Kerb4k/FI-EtherCAT/(list of files, drawings)

Other design files:
Universal slave/DB10012_ControlController.SchDoc
Universal slave/DB10012_ControlEtherCAT.SchDoc
Universal slave/DB10012_ControlIOConnector.SchDoc
Universal slave/DB10012_ControlPower.SchDoc
Universal slave/DB10012_ControlTopLevel.SchDoc
Universal slave/DB10012_ControlUSBSerial.SchDoc
Universal slave/DB10012_GyroNunchuck.PcbDoc
Universal slave/DB10012_GyroNunchuck.PrjPcb
Universal slave/DB10012_GyroTopLevel.SchDoc
Universal slave/DB10012_IMU.PcbDoc
Universal slave/DB10012_IMU.PrjPcb
Universal slave/DB10012_IMUTopLevel.SchDoc
Universal slave/DB10012_UniversalSlave.PrjPcb
