Kerb4k/FI-EtherCAT/KiCAD/FIU/FIU.kicad_pcb

## KiCad design KiCAD/FIU/FIU.kicad_pcb (2023-11-26)

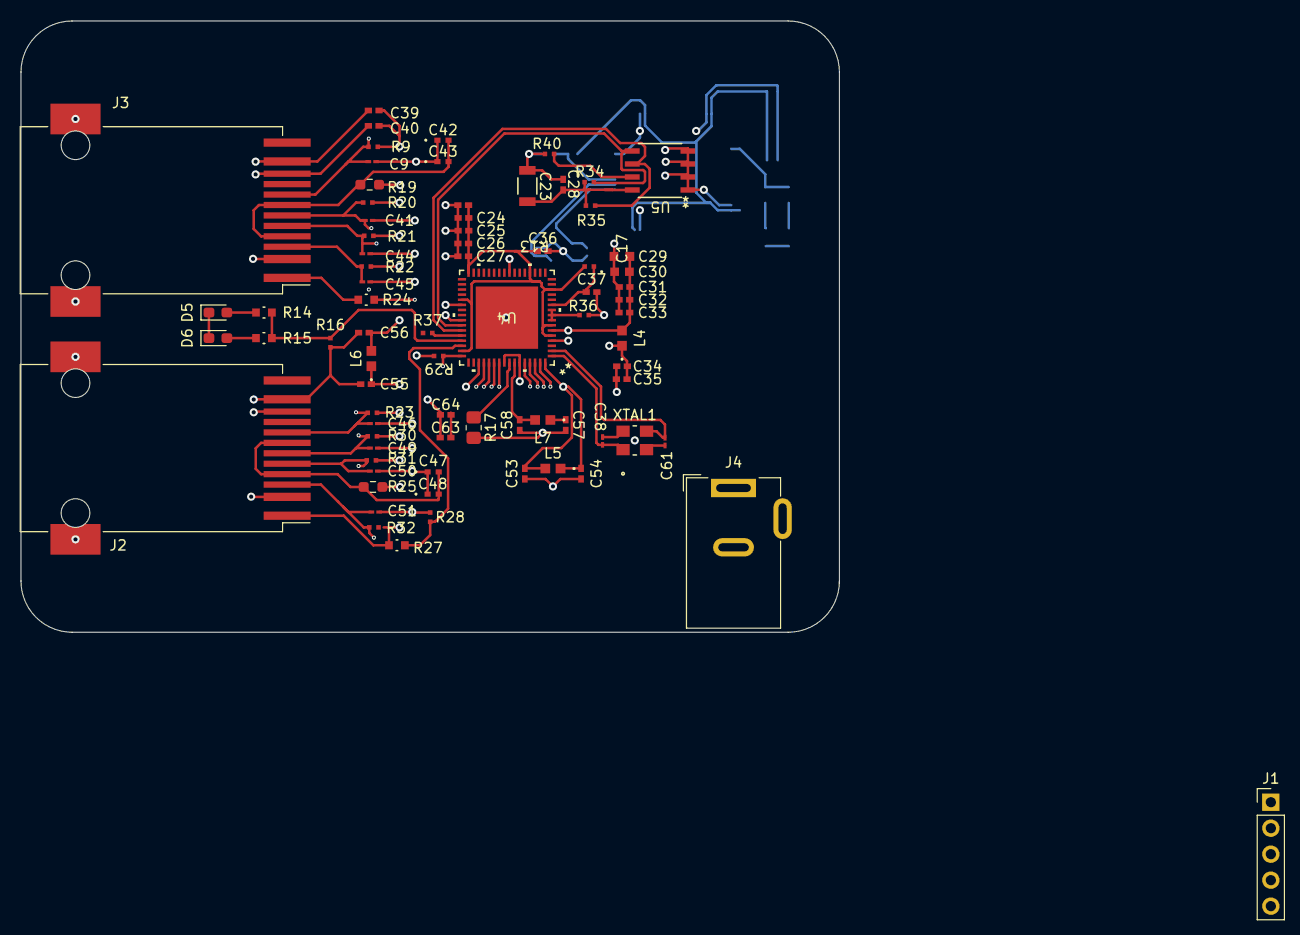
[picture p1: board FIU.kicad_pcb from above]

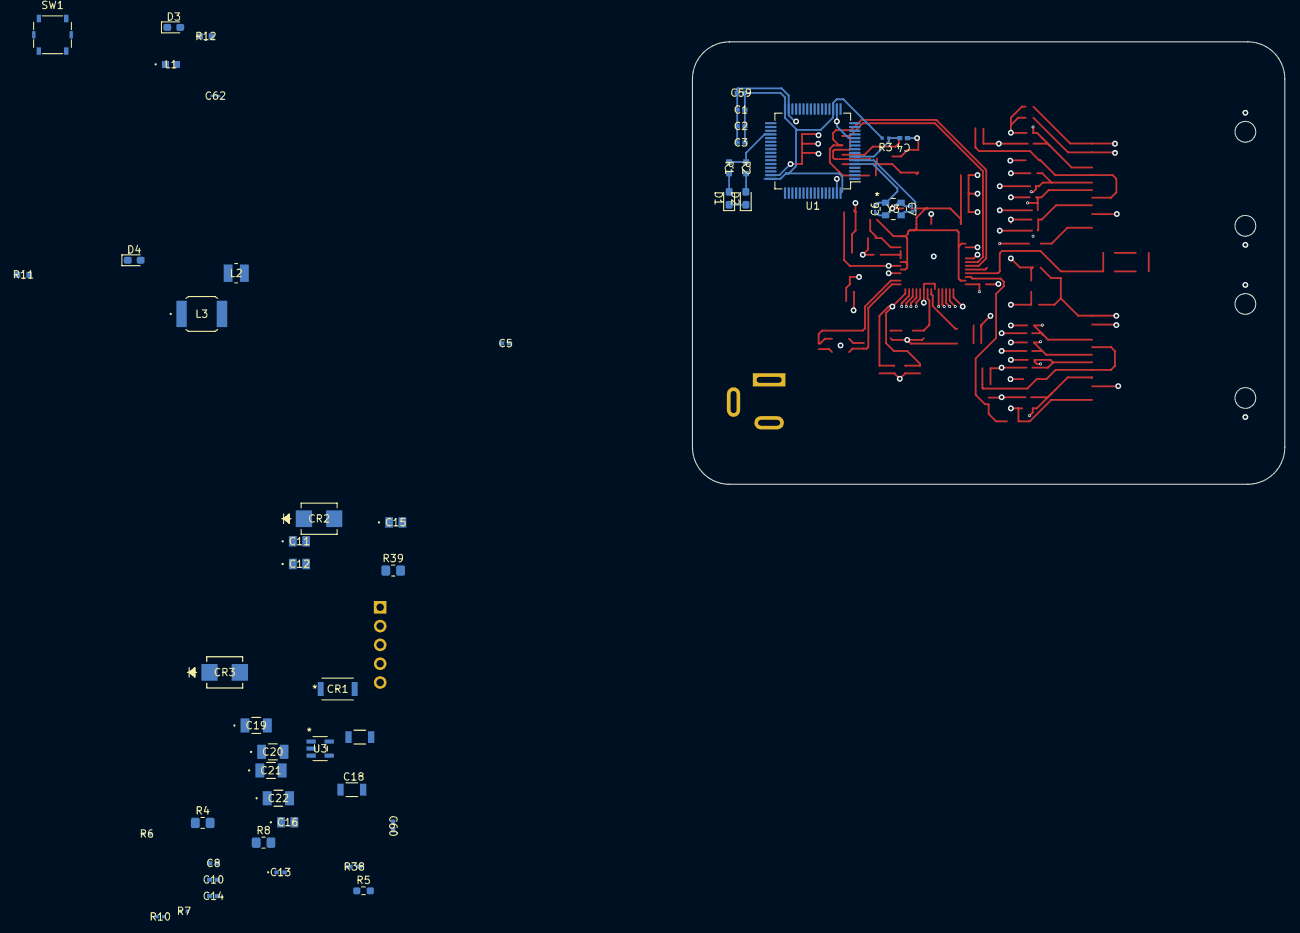
[picture p2: board FIU.kicad_pcb from below]

Board: 4 copper layers, 80.0 x 59.8 mm, 128 parts (51 on the bottom side), 59 nets.

Parts:
C1, C2, C3, C4, C5, C8, C10, C14, C17, C24, C25, C26, C27, C28, C31, C32, C33, C34, C35, C36, C37, C39, C40, C53, C54, C55, C56, C57, C58, C59, C60, C63, C64: 0.1uF; CAP_GRM155R71H104KE14J_MUR
C6, C7, C38, C61: 18pF; G-033_MUR
C9, C41, C44, C45, C46, C49, C50, C51, C62: 15pF; G-033_MUR
C11, C12, C15, C16: 4.7uF; CAP_GRM21_2p15X1p4X1p4_MUR
C13, C42, C43, C47, C48: 22nF; G-155_MUR
C18, C23, C52: 2.2uF; CAP_CL31_SAM
C19, C20, C21, C22: 10uF; CAP_UMK316BBJ106ML-T_TAY
C29: 1uF; CAP_GRT188R61H105KE13D_MUR
C30: 220pF; G-188_MUR
CR1: PMEG3050EP_115; SDO_CFP5_SOD128_NEX
CR2, CR3: STTH4R02U; SMB_STM
D1, D2: LED; LED_0603_1608Metric_Pad1.05x0.95mm_HandSolder
D3, D4, D5, D6: Green; LED_0603_1608Metric_Pad1.05x0.95mm_HandSolder
J1: Conn_01x05; PinHeader_1x05_P2.54mm_Vertical
J2, J3: RJ45_Wuerth_74980111211; RJ45_Wuerth_74980111211_Horizontal
J4: Barrel_Jack; BarrelJack_Wuerth_6941xx301002
L1, L4, L5, L6, L7: BLM18PG330SN1D; IND_BLM18_0603_MUR
L2: 2.2uH; IND_SRN2512_BRN
L3: 10uH; IND_IDC-2512_VIS
R1, R2, R11, R12, R14, R15, R24, R27: 470; RC0603N_PAN
R3, R13, R16, R28, R29, R34, R35, R36, R37, R40: 4.75k; RC0402N_PAN-L
R4: 110K; R_0805_2012Metric_Pad1.20x1.40mm_HandSolder
R5: 0.05; R_0603_1608Metric_Pad0.98x0.95mm_HandSolder
R6, R7, R10: 10k; RC0402N_PAN-L
R8: 100K; R_0805_2012Metric_Pad1.20x1.40mm_HandSolder
R9, R20, R21, R22, R23, R30, R31, R32: 49.9; RC0402N_PAN-L
R17: 12k1; R_0805_2012Metric_Pad1.20x1.40mm_HandSolder
R19, R25: 10; R_0603_1608Metric_Pad0.98x0.95mm_HandSolder
R38: 45k3; RC0402N_PAN-M
R39: 1.5k; R_0805_2012Metric_Pad1.20x1.40mm_HandSolder
SW1: SW_Push_Open_Dual; SW_SPST_Panasonic_EVQPL_3PL_5PL_PT_A15
U1: STM32F303RETx; LQFP-64_10x10mm_P0.5mm
U3: LMR10510XMFE/NOPB; MF05A
U4: LAN9252/ML; QFN64_ML_MCH
U5: M24C16-WMN6P; SO8N_4X5X1P27_STM
XTAL1: 25Mhz; ECX-32_SMDXTAL_ECS
Y3: 12Mhz; CRYSTAL_ABM8G_ABR

Connections:
+3.3V: C1.2, C2.2, C3.2, C59.2, L1.1, R3.1, U1.19 (VDD), U1.32 (VDD), U1.48 (VDD), U1.64 (VDD)
+3V3A: C39.2, C40.2, C55.2, C56.2, L6.1, L6.2, R9.1, R19.1, R20.1, R21.1, R22.1, U4.51 (VDD33TXRX1)
+3V3B: C53.2, C54.2, C63.2, C64.2, L5.1, L5.2, R23.1, R25.1, R30.1, R31.1, R32.1, U4.64 (VDD33TXRX2)
+5V: C10.2, C15.2, C16.2, C19.2, C20.2, C52.2, L3.1, R6.1, R8.1, U3.5 (VIN)
/UART1_RX: J1.4, U1.43 (PA10)
/UART1_TX: J1.3, U1.42 (PA9)
BOOT: R39.1, SW1.1, U1.60 (BOOT0)
GND: C1.1, C2.1, C3.1, C4.1, C5.1, C6.1, C7.1, C8.1, C9.1, C10.1, C11.1, C12.1, C13.1, C15.1, C16.1, C17.1, C18.1, C19.1, C20.1, C21.1, C22.1, C23.1, C24.1, C25.1, C26.1, C27.1, C28.1, C29.1, C30.1, C31.1, C32.1, C33.1, C34.1, C35.1, C36.1, C37.1, C38.1, C39.1, C40.1, C41.1, C42.1, C43.1, C44.1, C45.1, C46.1, C47.1, C48.1, C49.1, C50.1, C51.1, C52.1, C53.1, C54.1, C55.1, C56.1, C57.1, C58.1, C59.1, C60.2, C61.1, C62.1, C63.1, C64.1, CR1.2, D1.1 (K), D2.1 (K), D3.1 (K), D4.1 (K), D5.1 (K), D6.1 (K), J2.2, J2.10, J2.11, J2.SH, J3.2, J3.10, J3.11, J3.SH, J4.2, R5.2, R7.2, R10.2, R16.2, R17.2, R28.2, R29.2, R36.2, R39.2, R40.2, U1.12 (VSSA), U1.18 (VSS), U1.31 (VSS), U1.47 (VSS), U1.63 (VSS), U3.2 (GND), U4.4 (OSCVSS), U4.41 (TESTMODE), U4.65 (VSS), U5.1 (NC), U5.2 (NC), U5.3 (NC), U5.4 (VSS), XTAL1.2 (GND), XTAL1.4 (GND), Y3.2, Y3.4
IRQ: R37.2, U1.34 (PB13), U4.44 (IRQ)
LAN_SYNC0: U1.35 (PB14), U4.34 (SYNC0/LATCH0)
LAN_SYNC1: U1.26 (PB0), U4.18 (SYNC1/LATCH1)
unnamed: C60.1, CR3.1, J4.1
unnamed: D1.2 (A), R1.2
unnamed: D2.2 (A), R2.2
unnamed: D3.2 (A), R11.2
unnamed: D4.2 (A), R12.2
unnamed: D5.2 (A), R14.2
unnamed: D6.2 (A), R15.2
unnamed: J1.1, U1.46 (PA13)
unnamed: J1.2, U1.49 (PA14)
unnamed: J2.1, R27.1
unnamed: C47.2, C48.2, J2.4 (TCT), J2.7 (RCT), R25.2
unnamed: C49.2, J2.6 (RD+), R30.2, U4.60 (RXPB)
unnamed: C46.2, J2.8 (RD-), R23.2, U4.61 (RXNB)
unnamed: C51.2, J2.3 (TD+), R32.2, U4.62 (TXPB)
unnamed: C50.2, J2.5 (TD-), R31.2, U4.63 (TXNB)
unnamed: J3.1, R24.1
unnamed: C42.2, C43.2, J3.4 (TCT), J3.7 (RCT), R19.2
unnamed: C41.2, J3.6 (RD+), R20.2, U4.55 (RXPA)
unnamed: C9.2, J3.8 (RD-), R9.2, U4.54 (RXNA)
unnamed: C45.2, J3.3 (TD+), R22.2, U4.53 (TXPA)
unnamed: C44.2, J3.5 (TD-), R21.2, U4.52 (TXNA)
unnamed: R1.1, R2.1, U1.36 (PB15)
unnamed: C6.2, U1.5 (PF0), Y3.1
unnamed: C7.2, U1.6 (PF1), Y3.3
unnamed: C5.2, C62.2, L1.2, U1.13 (VDDA)
unnamed: CR2.1, R5.1
unnamed: R6.2, R7.1
unnamed: C14.1, CR2.2, L3.2
unnamed: C8.2, C11.2, C12.2, CR3.2, R4.1
unnamed: R8.2, U3.4 (EN)
unnamed: R10.1, R38.2, U3.3 (FB)
unnamed: CR1.1, L2.1, U3.1 (SW)
unnamed: R36.1, U4.8 (FXLOSEN), U4.9 (FXSDA/FXLOSA/FXSDENA), U4.10 (FXSDB/FXLOSB/FXSDENB)
unnamed: R24.2, R29.1, U4.48 (LINKACTLED0/TDO/CHIP_MODE0)
unnamed: R27.2, R28.1, U4.46 (LINKACTLED1/TDI/CHIP_MODE1)
unnamed: C38.2, U4.1 (OSCI), XTAL1.1 (CRYSTAL)
unnamed: C61.2, U4.2 (OSCO), XTAL1.3 (CRYSTAL)
unnamed: R17.1, U4.57 (RBIAS)
unnamed: C37.2, R13.2, U4.11 (RST#)
unnamed: R14.1, R15.1, R16.1, U4.45 (RUNLED/E2PSIZE)
unnamed: C58.2, L7.2, U4.58 (VDD33BIAS)
unnamed: R40.1, U5.7 (*WC)
RESET: C4.2, J1.5, R3.2, U1.7 (NRST)
TCK: R35.2, U4.43 (EESCL/TCK), U5.6 (SCL)
TMS: R34.2, U4.42 (EESDA/TMS), U5.5 (SDA)
VDD12TX: C34.2, C35.2, L4.1, U4.56 (VDD12TX1), U4.59 (VDD12TX2)
VDDCR: C29.2, C30.2, C31.2, C32.2, C33.2, L4.2, U4.6 (VDDCR), U4.24 (VDDCR), U4.38 (VDDCR)
VDDIO: C17.2, C18.2, C21.2, C22.2, C23.2, C24.2, C25.2, C26.2, C27.2, C28.2, C36.2, C57.2, L2.2, L7.1, R11.1, R12.1, R13.1, R34.1, R35.1, R37.1, R38.1, SW1.2, U4.5 (VDD33), U4.7 (REG_EN), U4.14 (VDDIO), U4.20 (VDDIO), U4.32 (VDDIO), U4.37 (VDDIO), U4.47 (VDDIO), U5.8 (VCC)
