Kerb4k/FI-EtherCAT/(commit log)

2023-11-03 some changes
    [DB10012_ControlController.SchDoc, DB10012_ControlEtherCAT.SchDoc, DB10012_ControlPower.SchDoc, DB10012_ControlTopLevel.SchDoc, DB10012_UniversalSlave.csv, DB10012_UniversalSlave.xlsx, EtherCAT.kicad_sch, FIU.kicad_pcb]
2023-11-10 finished ethercat part
    [DB10012_ControlEtherCAT.SchDoc, DB10012_ControlPower.SchDoc, EtherCAT.kicad_sch, FIU.kicad_sch, power.kicad_sch]
2023-11-12 new level
    [FIU.kicad_sch, fiu_board.kicad_sch, power.kicad_sch]
2023-11-19 updated libraries
    [DB10012_ControlController.SchDoc, DB10012_ControlEtherCAT.SchDoc, DB10012_ControlIOConnector.SchDoc, DB10012_ControlPower.SchDoc, DB10012_ControlTopLevel.SchDoc, DB10012_ControlUSBSerial.SchDoc, DB10012_GyroNunchuck.PcbDoc, DB10012_GyroNunchuck.PrjPcb]
2023-11-26 finished front of pcb
    [EtherCAT.kicad_sch, FIU.kicad_pcb, FIU.kicad_sch]
